manye31/automatic-feeder/docs/schematic/uC1_UserInterface_Schematic.pdf

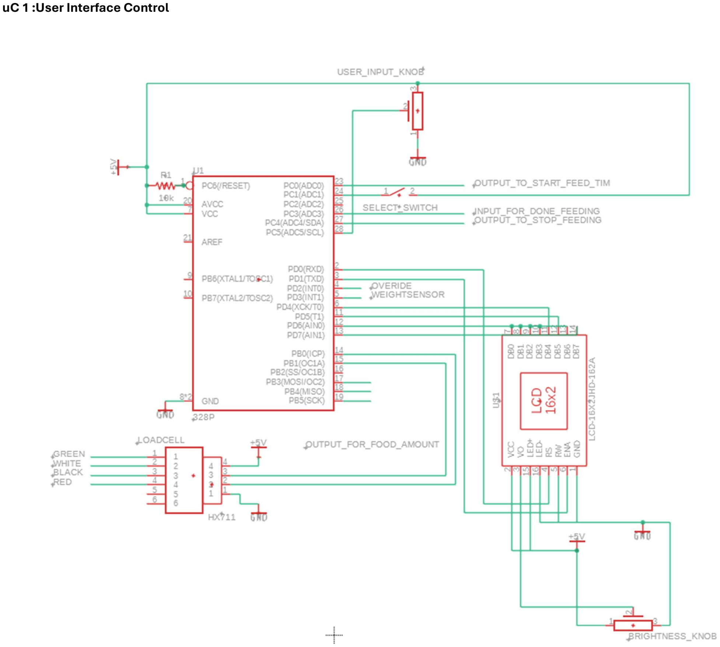
[picture p2: page 1]

uC 1 :User Interface Control
