manye31/automatic-feeder/docs/schematic/Water Valve Schematic.jpg

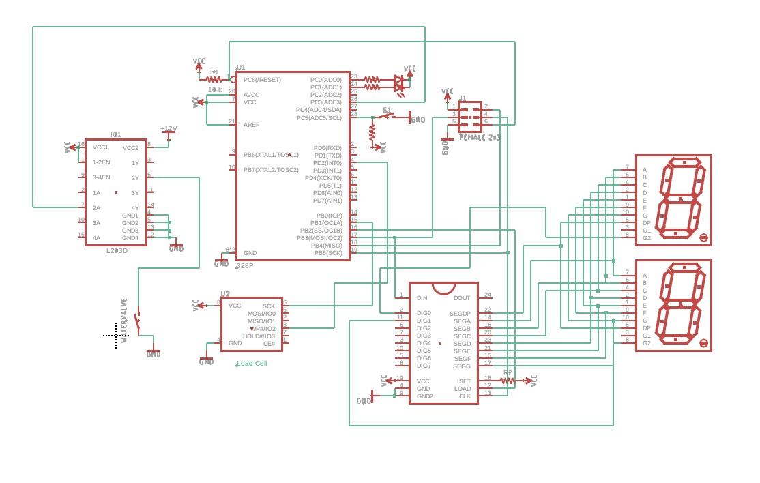
docs/schematic/Water Valve Schematic.jpg
