manye31/automatic-feeder/docs/schematic/uc2_motor_control_schematic_uc1_comms.pdf

## Chute Flap Stepper Motor

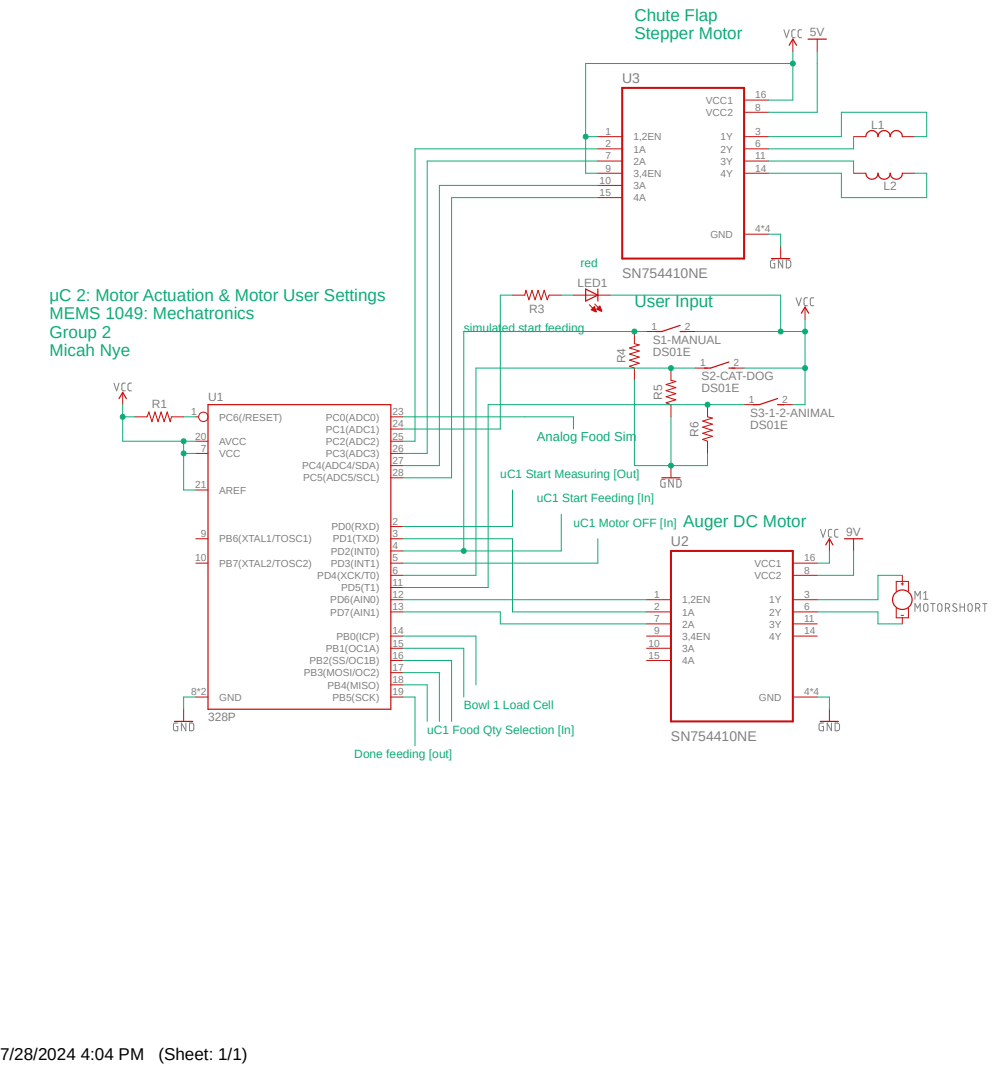
[picture p4: page 1]

Bowl 1 Load Cell
uC1 Food Qty Selection [In]
