manye31/automatic-feeder/uc2_motor_controller/main.c

/*
 * main.c
 *
 * Created: 6/29/2024 1:55:43 PM
 * Author : Micah Nye
 */ 

#include <avr/io.h>
#include <avr/interrupt.h>
#include "hx711.h"	   // Include folder for amplifier

// Debug variables
char WEIGHT_SIM = 0;

// PORTB Pins
#define RED_LED 0x02            // Red LED bit PC1
#define STARTED_FEEDING 0x20    // Done feeding PB5
#define YELLOW_LED 0x40         // Yellow LED PB6
#define BLUE_LED 0x80           // Blue LED PB7

// PORTD Pins
#define START_MEASURING 0b00000001 // Start measuring bit PD0

// Food parameters
#define FOOD_DENSITY 70 // [g/cup]
#define MAX_FOOD_VOL 4 // [cup]

// Auger States
#define CAT         0x00
#define DOG         0x01

// Functions
double readFoodLevels(void);
void fillFoodBowls(void);
void fillWaterBowl(void);
void motorOffSequence(void);
void augerCommand(enum AugerMode mode);
double readServingSize(void);

void step_cw(void);
void step_ccw(void);
void rotate(int deg, char dir, float stride, float rot_t);

void wait(volatile int msec);
void LED_TOGGLE(char led, char port, char on);

// Auger State
enum AugerMode {
    OFF,
    SLOW,
    FAST,
    JIGGLE
};

// Hx711 Setup 
int8_t gain = HX711_GAINCHANNELA128;
int32_t offset = 8433560;
double calibrationweight = 82.0;
int32_t calib_offset = 8440750;
double scale = 25;

// Init global var (crude)
// Food quantity tracking
float food_serving_size = 0.0; // food serving size
double food_weight = 0.0; // food bowl level (from load cell or pot)

double original_food_weight = 0;
double target_food_weight = 0;
double rel_food_weight = 0;

// Motor control modes
char food_size_mode = 0; // 0 - Cat food, 1 - dog food
char pet_num = 1; // Pet number
enum AugerMode AUGER_MODE;

// Flags
char begin_feed = 0; // feed flag
char begin_water = 0; // water flag
char food_stuck = 0; // Assume food is not stuck

// Stepper motor
float STRIDE = 7.5; // [deg]; Motor model ST_PM35_15_11C stride
char phase_step = 1; // current phase step for stepper

int main(void)
{
    // Registers
    DDRD = 0b11000011; // PD0 - uC1 start measuring [Out]
                       // PD1 - motor dir output M1
                       // PD2 - uC1 Manual mode INT input, also food stuck [IN]
                       // PD3 - uC1 Turn motor OFF [IN]
                       // PD4 - Cat/dog toggle simulator input
                       // PD5 - Animal toggle (WIP)
                       // PD6 - PWM output
                       // PD7 - motor dir output M2

    DDRC = 0b0111110; // PC1 - RED LED
                      // PC2 - Stepper 2b
                      // PC3 - Stepper 2a
                      // PC4 - Stepper 1b
                      // PC5 - Stepper 1a
    
    DDRB = YELLOW_LED | BLUE_LED | STARTED_FEEDING; // PB0-1 Bowl 1 Load cell amplifier
                                                    // PB2-4 uC1 Food Qty Select [IN]
                                                    // PB5 Started feeding [OUT]
                                                    // PB6 Blue LED
                                                    // PB7 Yellow LED
    
    PORTB = YELLOW_LED | BLUE_LED; // Default LEDs to OFF
    PORTC = RED_LED; // Default LEDs to OFF
	
    /* ADC Setup */
    // ADC Multiplexer
    ADMUX = 0b00100000;  // (6-7) REF set to 00 (AREF)
                         // (5) ADLAR to 1 (Left-just)
                         // (3-0) MUX to 0000 (PC0)
    
    // Power reduction register
    PRR = 0x00;          // Power ADC on

    // ADC Control and Status Register A
    ADCSRA = 0b10000011; // (7) Enable ADC (ADEN)
                         // (6) ADC Start conversion - 0 (not started yet)
                         // (5) Auto Trigger Enable - 0 disabled
                         // (4) ADC INT Flag - 0 
                         // (3) ADC Interrupt Enable flag - 0 (INT disabled)
                         // (2-0) Prescaler of 8. 1MHz/8 = 125KHz.
                         //       125 KHz/13 ~= 10kHz

    /* PWM @ D6 (TC0 -- 8bit) */
    // Timer counter control register A for Timer 0
    TCCR0A = 0b10000011; // (7-6) Non-inverting mode for A0
                         // (5-4) Disconnect OC0B
                         // (1-0) Fast PWM mode (X11)
    
    // Timer counter control register B for Timer 0
    TCCR0B = 0b00000001; // (7-6) No compare flags (OCF0A/B)
                         // (3)   Fast PWM mode (0XX)
                         // (2-0) Default clock source to 1 prescaler
                         //       F_PWM = (1MHz)/(256*1) = 4kHz ~ 1kHz
    
    // Output compare register preset
	OCR0A = 0x00;        // Preset duty cycle to 0

    // INTERRUPTS
    EICRA = 0b0000011; // Rising edge for INT0. Switch configured
                        // as active high, so rising edge is at press-in
	EIMSK = 0b00000001; // Enable INT0
	sei(); // Enable global interrupts

    // Init Amplifier
	hx711_init(gain, scale, offset);
	
    while (1) 
    {
		// Read food sensors
		food_weight = readFoodLevels();

        // Read food serving size
        food_serving_size = readServingSize();

        // Read food size mode input
        if (PIND & 0b00010000) {
            // Toggle food size mode
            food_size_mode = !food_size_mode;
            LED_TOGGLE(BLUE_LED, 'B', food_size_mode);
        }

        // Read animal count mode input
        if (PIND & 0b00100000) {
            // Toggle animal count mode between 1 and 2
            char temp = pet_num + 1;
            if (temp > 2) {
                pet_num = 1;
                LED_TOGGLE(YELLOW_LED, 'B', 0);
            }  else {
                pet_num += 1;
                LED_TOGGLE(YELLOW_LED, 'B', 1);
            }
        }

        // Set auger mode
        if (food_size_mode == CAT) {
            AUGER_MODE = SLOW;
        } else if (food_size_mode == DOG) {
            AUGER_MODE = FAST;
        }

        if (begin_feed == 1) {
            fillFoodBowls();
        }

        if (begin_water == 1) {
            fillWaterBowl();
        }

        // Loop reset
        begin_feed = 0;
        begin_water = 0;
        food_stuck = 0;
    }   
}

/* Manual Override Button */
ISR(INT0_vect) {
    /**
     * @brief Interrupt for manual feed override
     * 
     */

    begin_feed = 1; // Manual override button pressed=
    EIFR = 0b00000001;
}

void fillFoodBowls(void) {
    /**
     * @brief Fill food bowls
     * 
     * @details There are 2 modes defined by WEIGHT_SIM variable. IF WEIGHT_SIM
     * then we use the pot to sim weight. This will increment through the number
     * of pets and feed them until the relative weight of the bowl exceeds the
     * user-input serving size.
     * 
     * If in 2-pet mode, the stepper will switch and wait for a flag to be sent
     * from uC1 to stop rotating. There was no space to read from another
     * amplifier, so we use a crude wire communication between the uC's
     * 
     */

    char current_bowl = 0; // Init bowl we are feeding
    char chute_gate_switched = 0; // Default gate state to not switched
    original_food_weight = readFoodLevels();

    if (!WEIGHT_SIM) {
        target_food_weight = food_serving_size * FOOD_DENSITY;

        // Truncate target
        if (target_food_weight + original_food_weight > (MAX_FOOD_VOL * FOOD_DENSITY)) {
            target_food_weight = (MAX_FOOD_VOL -  food_serving_size) * FOOD_DENSITY;
        }
    } else {
        target_food_weight = 127;
    }
    
    while (current_bowl < pet_num) {
        // Set STARTED_FEEDING bit high to alert uc1.
        PORTB |= STARTED_FEEDING;

        rel_food_weight = original_food_weight - readFoodLevels();
        int stuck_t = 0; // Crude time tracking

        if (current_bowl == 0) {
            while (rel_food_weight < target_food_weight) {
                // Wait 10s for until jiggle mode
                wait(10);
                stuck_t += 10;

                // Read food level
                if (!WEIGHT_SIM) {
                    rel_food_weight = readFoodLevels() - original_food_weight;
                } else {
                    rel_food_weight = readFoodLevels(); // Not actually relative weight
                }
                            
                // If auger set to move and stuck, jiggle
                if (AUGER_MODE > OFF && stuck_t > 500) {
                    augerCommand(JIGGLE); // Will retain old auger mode
                    stuck_t = 0; // Reset stuck_time
                } else {
                    augerCommand(AUGER_MODE);
                }
            }
        } else {
            while (!(PIND & 0b00001000)) {
                augerCommand(AUGER_MODE);
            }
        }
        motorOffSequence();

        // First pet feed, load in next, if applicable
        current_bowl++;
        food_stuck = 0;

        if ((current_bowl == 1 && pet_num == 2) || chute_gate_switched == 1) {
            // flip chute gate
            // Rotate 90d CW/CCW in 2 second
            rotate(120, !chute_gate_switched, STRIDE, 1000);
            // State init 0: We rotate CCW, Set to 1, now we rotate CW      
            PORTC &= 0b1000011; // Turn stepper OFF
            chute_gate_switched = !chute_gate_switched; // Update state to reflect it being switched  

            // If on second bowl, send signal to uC1 to start measuring food
            if (current_bowl == 1) {
                PORTD |= START_MEASURING;
            }

        } // else, exit while loop
    }

    // Send done feeding signal to uC1
    PORTB &= ~STARTED_FEEDING;
    PORTD &= ~START_MEASURING; // Start measuring OFF
}

void fillWaterBowl(void) {
    /**
     * @brief Placeholder for filling water bowl
     * 
     */
}

void motorOffSequence(void) {
    /**
     * @brief Helper function to turn motor off
     * 
     */

    augerCommand(OFF); // OFF Signal
    
    PORTC &= ~RED_LED; // Turn LED1 (red) ON
    wait(200);
    PORTC |= RED_LED; // Turn LED1 (red) OFF
    wait(200);
    PORTC &= ~RED_LED; // Turn LED1 (red) ON
    wait(200);
    PORTC |= RED_LED; // Turn LED1 (red) OFF
}

void augerCommand(enum AugerMode mode) {
    /**
     * @brief Command auger based on AugerMode state
     * 
     */

    switch (mode) {
        case OFF:
        OCR0A = 0x00; // Stop motor
        PORTD &= 0b01111101; // Clear M1 and M2 in H-bridge
		break;
        case SLOW:
        OCR0A = 225; // Rotate motor slowly
        PORTD &= 0b11111101; // Clear M1
        PORTD |= 0b10000000; // Set M2
        break;
        case FAST:
        OCR0A = 255; // Rotate motor quickly
        PORTD &= 0b11111101; // Clear M1
        PORTD |= 0b10000000; // Set M2
        break;
        case JIGGLE:
        OCR0A = 255;
        PORTD &= 0b11111101; // Clear M1
        PORTD |= 0b10000000; // Set M2
        wait(300);
        PORTD &= 0b01111111; // Clear M1
        PORTD |= 0b00000010; // Set M2
        wait(300);
        PORTD &= 0b11111101; // Clear M1
        PORTD |= 0b10000000; // Set M2
        wait(300);
        PORTD &= 0b01111111; // Clear M1
        PORTD |= 0b00000010; // Set M2
        wait(300);
        break;
    }
}

double readFoodLevels(void) {
    /**
     * @brief Read in food levels
     * 
     * @details uC2 (this uC) will read the first bowl. uC1 reads the second
     * bowl and sends high level commands to toggle the motor on/off when at
     * right threshold
     * 
     * @return level of the food bowl
     * 
     */

    double level = 0;

    if (WEIGHT_SIM) {
        // OR Read Simulated ADC
        // Start ADC conversion
        ADCSRA |= 0b01000000; // Set ADSC bit (start conversion)

        // Wait for conversion to finish
        // while (ADCSRA & (1 << ADSC)); // Polling ADSC until cleared (conversion finished)
        //                               // Not using INT because INT1 needed for other functionality
        while ((ADCSRA & 0b00010000) == 0) // While ADIF bit not set
                                            // (INT flag when conversion complete)
        level = ADCH; // Read in simulated "food level" from potentiometer
    } else {
        // Read from load cell amplifier
        level = hx711_getweight();
    }

    return level;

    // If bowl 1+, no need to read. Wait for toggle OFF command from uC1
}

double readServingSize(void) {
    /**
     * @brief Read serving size from naive binary input from uC1 and return
     * respective serving size
     * 
     * @return serving size
     * 
     */
    
    char uc1_input = (PINB & 0b00011100) >> 2;

    if (uc1_input == 0) {
        return 0.25;
    } else if (uc1_input == 1) {
        return 0.50;
    } else if (uc1_input == 2) {
        return 0.75;
    } else if (uc1_input == 3) {
        return 1.00;
    } else if (uc1_input == 4) {
        return 4.00;
    } else if (uc1_input == 5) {
        return 1.50;
    } else if (uc1_input == 6) {
        return 3.00;
    } else if (uc1_input == 7) {
        return 2.00;
    }
	return 0.0;
}

void wait(volatile int msec) {
    /**
     * @brief wait for a number of milliseconds, assuming a 1MHz clock-cycle
     * 
     * @param msec [ms] number of milliseconds
     * 
     */

    char count_limit = 125;


    while (msec > 0) {
        // Put timer into normal mode
		// Only using TC1 temporarily for this simulation. In reality, TC1 will be used for clock time approx.
        TCCR1A = 0x00; // Set bits 0-1 (WGM00, WGM01) to low
        TCNT1 = 0x00; // Preload timer to 0

        // Set timer mode (Set CS00, CS01, CS02)
        // Set prescaler of 8 because 1MHz / (8 * 125) = 1KHz; T = 1ms
        TCCR1B = 0b00000010; 

        while (TCNT1 < count_limit);

        // Stop TIMER1
        TCCR1B = 0x00;
        msec--;
    }
}

void rotate(int deg, char dir, float stride, float rot_t) {
    /**
     * @brief rotate motor counter clockwise
     * 
     * @param deg [deg] total rotation angle
     * @param dir [-] direction. 1 (CCW), 0 (CW)
     * @param stride [deg] motor stride, in same units as deg
     * @param rot_t [ms] time to complete rotation in
     * 
     */
    
    int total_steps = deg/stride; // Undershoot if not perfect
    int wait_t = rot_t/total_steps; // [ms] trim off microsecond decimal
    
    // Define step type
    void (*step)(void);
    if (dir == 1) {
        // ccw
        step = step_ccw;
    } else {
        // cw
        step = step_cw;
    }

    for (int t = 0; t < total_steps; ++t) {
        step();
        wait(wait_t);
    }
}

void step_ccw(void) {
    /**
     * @brief Step the motor phase counter-clockwise 1 step
     * 
     * @details Phases: (1a = C5) (1b = C4) (2a = C3) (2b = C2)        
     * 
     */

    switch (phase_step) {
        case 1:
        // step to 2
        PORTC &= 0b1000011;
        PORTC |= 0b0000100;
        phase_step = 2;
        break;
        case 2:
        // step to 3
        PORTC &= 0b1000011;
        PORTC |= 0b0010000;
        phase_step = 3;
        break;
        case 3:
        // step to 4
        PORTC &= 0b1000011;
        PORTC |= 0b0001000;
        phase_step = 4;
        break;
        case 4:
        // step to 1
        PORTC &= 0b1000011;
        PORTC |= 0b0100000;
        phase_step = 1;
        break;
    }
}

void step_cw(void) {
    /**
     * @brief Step the motor phase counter-clockwise 1 step
     * 
     * @details Phases: (1a = C5) (1b = C4) (2a = C3) (2b = C2)        
     * 
     */

    switch (phase_step) {
        case 1:
        // step to 4
        PORTC &= 0b1000011;
        PORTC |= 0b0001000;
        phase_step = 4;
        break;
        case 2:
        // step to 1
        PORTC &= 0b1000011;
        PORTC |= 0b0100000;
        phase_step = 1;
        break;
        case 3:
        // step to 2
        PORTC &= 0b1000011;
        PORTC |= 0b0000100;
        phase_step = 2;
        break;
        case 4:
        // step to 3
        PORTC &= 0b1000011;
        PORTC |= 0b0010000;
        phase_step = 3;
        break;
    }
}

void LED_TOGGLE(char led, char port, char on) {
    /**
     * @brief Basic LED toggle function for given led, port, and state
     * 
     * @param led - LED to toggle
     * @param port - PORT to set, in literal substitution
     * @param on - LED state to toggle to
     * 
     */

    if (on) {
        switch (port) {
            case 'B':
                PORTB &= ~led;
                break;
            case 'C':
                PORTC &= ~led;
                break;
            case 'D':
                PORTD &= ~led;
                break;
            default:
                break;
        }
    } else {
        switch (port) {
            case 'B':
                PORTB |= led;
                break;
            case 'C':
                PORTC |= led;
                break;
            case 'D':
                PORTD |= led;
                break;
            default:
                break;
        }
    }
    wait(200);
}
