manye31/automatic-feeder/(commit log)

2024-07-25 working proto motor control interface
2024-07-25 working stepper motor
2024-07-28 2 pet stepper swivel logic
2024-07-28 working motor controller. Testing with UI
2024-07-29 add LED toggle
2024-07-29 jiggle mode pin fix
    [main.c]
2024-07-31 add water valve code
