manye31/automatic-feeder/docs/animal_feeder.jpg

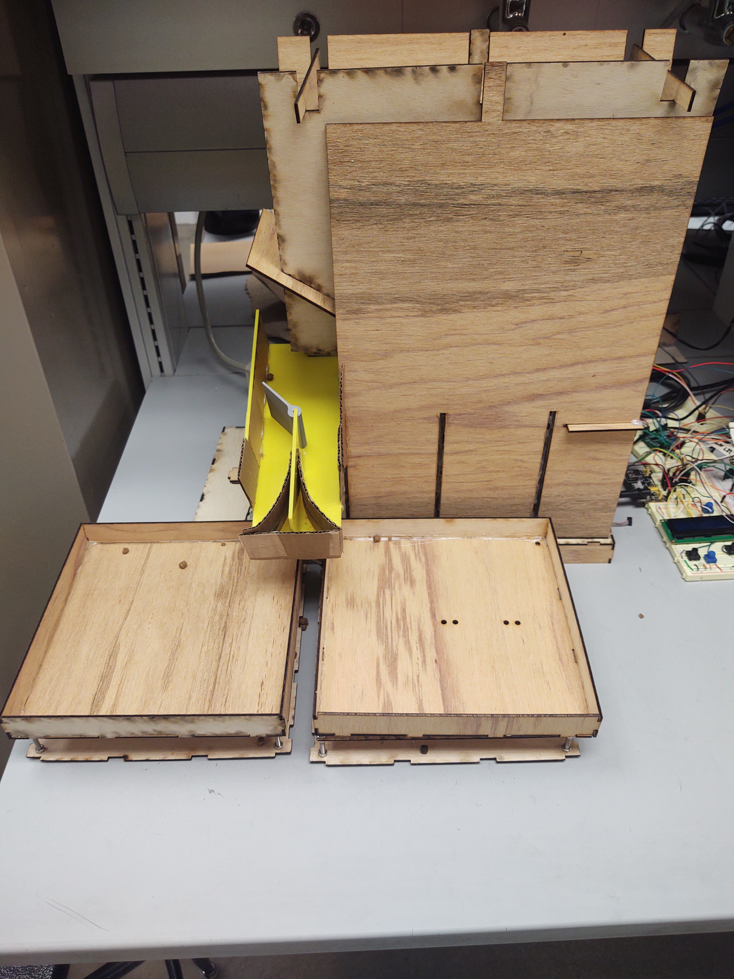
[picture p1: docs/animal_feeder.jpg]
docs/animal_feeder.jpg
